SRICHARAN010/Inverting-Schmitt-Trigger-Noise-Rejection/LTspice/circuit_diagram.asc

B1: bv; V=WHITE(1000*time)
R1: res; 10k
R2: res; 10k
R3: res; 10k
R4: res; 6.1k
R5: res; 1k
R: res; 130k
U1: LM741
V1: voltage; SINE(0 10 100); AC 1
V3: voltage; 15
V4: voltage; 15
Named nets: 0, V+, V-, Vref, Vout, Vin, Noise, Sine
.tran 100ms
